putu-studio/AI_Pin/hardware/production/bom.csv

Designator | Footprint | Quantity | Value | LCSC Part #
C1 | 0603 | 1 | 10uF | C19702
C2 | 0603 | 1 | 100nF | C14663
C3, C4, C5, C9 | 0603 | 4 | 100 nF | C14663
C6 | 1206 | 1 | 47 uF | C96123
C7, C8 | 0805 | 2 | 10 uF | C15850
D1 | 0603 | 1 | red LED | C2286
D2 | 0603 | 1 | green LED | C84267
D3 | D_SOD-123F | 1 | SMF5.0A | C284108
J4 | USB_C_Receptacle_HRO_TYPE-C-31-M-12 | 1 | USB_C_Receptacle_USB2.0_16P | C165948
Q1 | SOT-23 | 1 | Q_PMOS_GSD | C15127
R1, R2, R8 | 0603 | 3 | 100 kΩ | C25803
R3 | 0603 | 1 | 2.4 kΩ | C22940
R4 | 0603 | 1 | 2.2 kΩ | C4190
R5 | 0603 | 1 | 4.7 kΩ | C23162
R6, R7 | 0603 | 2 | 5.1 kΩ | C23186
SW1 | SW_Talk_6x6_TS6635PA | 1 | SW_talk | C55213946
SW2 | SW_Side_TS1114S | 1 | SW_pages | C596266
SW3 | SW_Side_TS1114S | 1 | SW_settings | C596266
SW4 | SW_Slide_MSK12C02HB | 1 | SW_SPDT | C431541
U2 | SOIC-8-1EP_3.9x4.9mm_P1.27mm_EP2.41x3.3mm | 1 | TP4056-42-ESOP8 | C16581
