putu-studio/AI_Pin/hardware/aipin-carrier.kicad_pcb

## KiCad design hardware/aipin-carrier.kicad_pcb (2026-11-07)

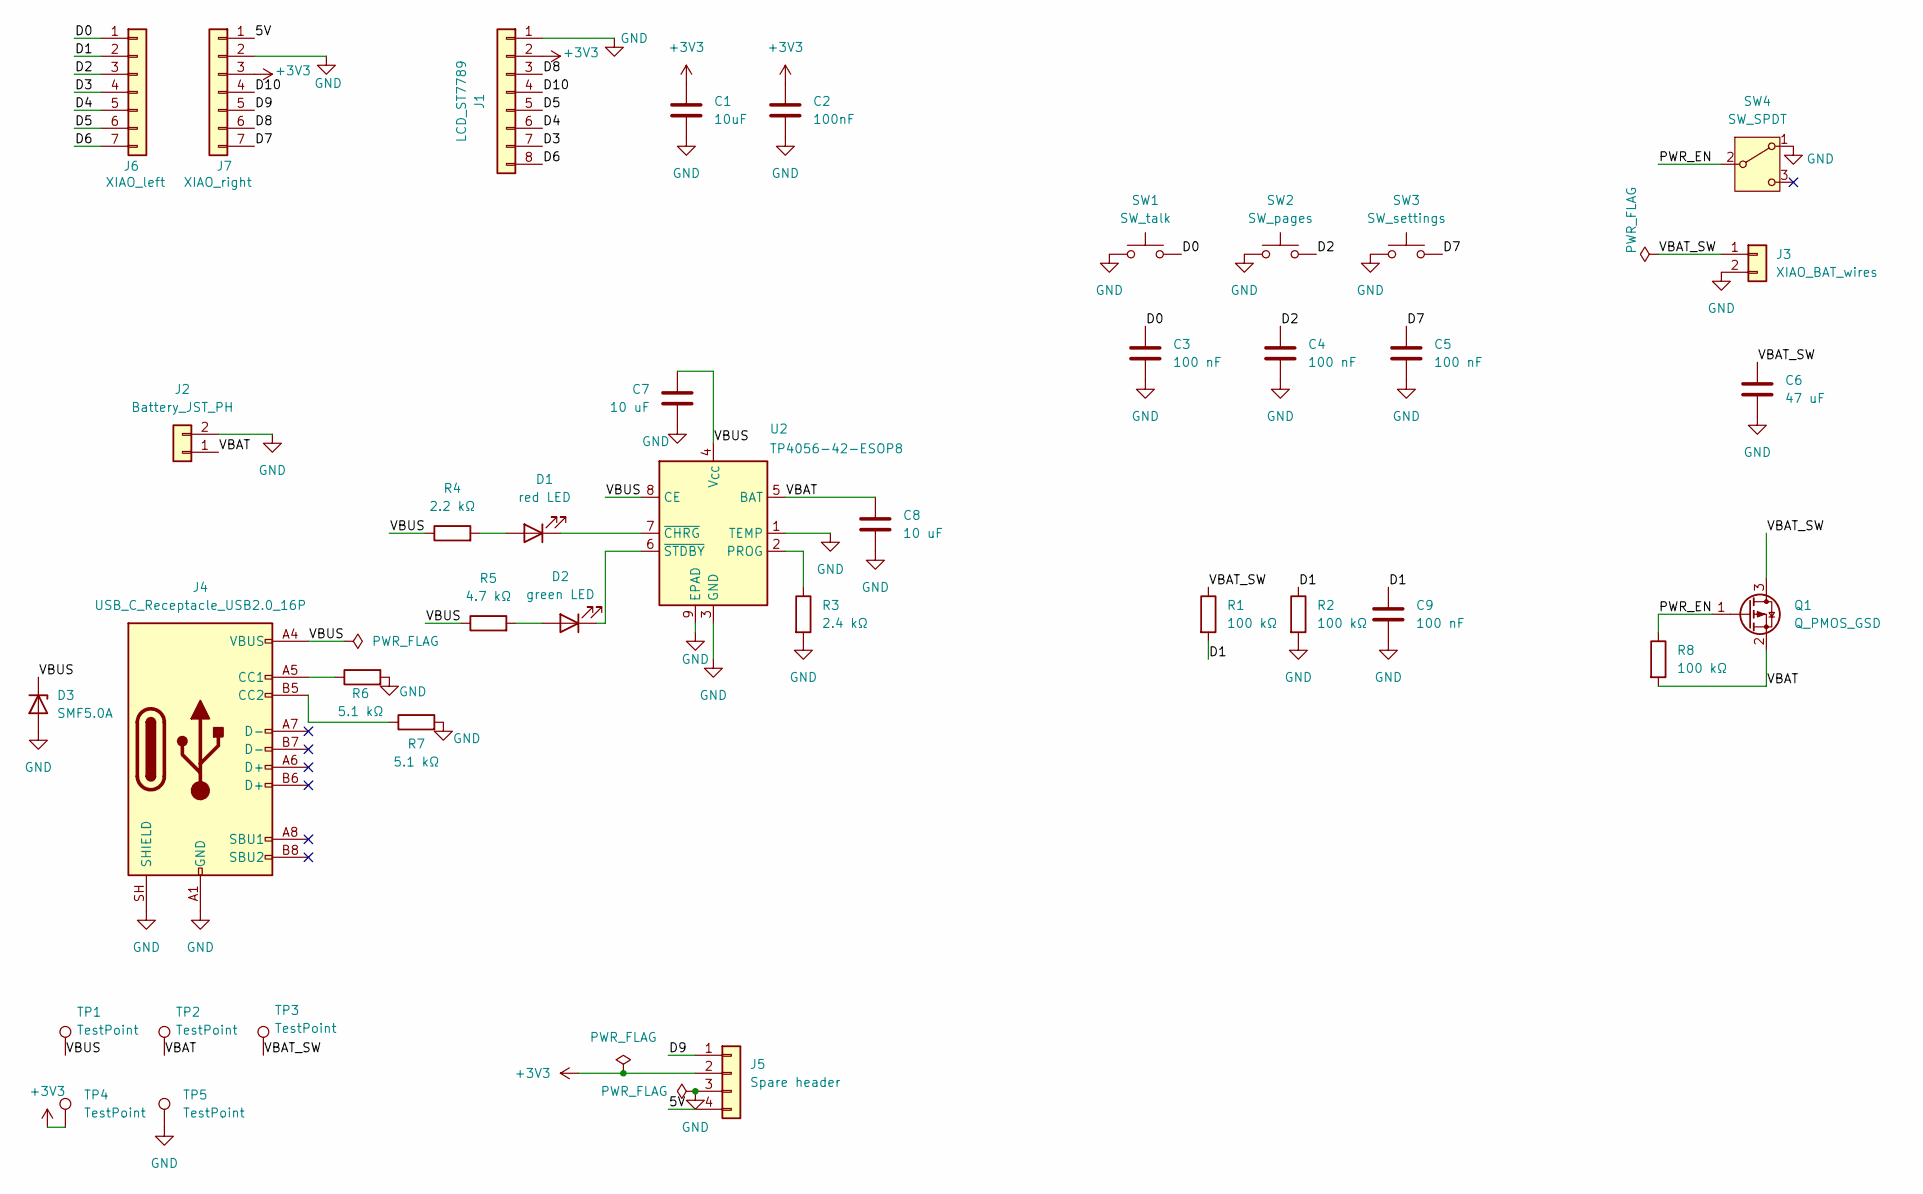
[picture p1: schematic aipin-carrier.kicad_sch]

Parts:
C1: 10uF; C_0603_1608Metric; LCSC C19702
C2: 100nF; C_0603_1608Metric; LCSC C14663
C3, C4, C5, C9: 100 nF; C_0603_1608Metric; LCSC C14663
C6: 47 uF; C_1206_3216Metric; LCSC C96123
C7, C8: 10 uF; C_0805_2012Metric; LCSC C15850
D1: red LED; LED_0603_1608Metric; LCSC C2286
D2: green LED; LED_0603_1608Metric; LCSC C84267
D3: SMF5.0A; D_SOD-123F; LCSC C284108
J1: LCD_ST7789; PinSocket_1x08_P2.54mm_Vertical
J2: Battery_JST_PH; JST_PH_S2B-PH-K_1x02_P2.00mm_Horizontal
J3: XIAO_BAT_wires; PinHeader_1x02_P2.54mm_Vertical
J4: USB_C_Receptacle_USB2.0_16P; USB_C_Receptacle_HRO_TYPE-C-31-M-12; LCSC C165948
J5: Spare header; PinHeader_1x04_P2.54mm_Vertical
J6: XIAO_left; PinSocket_1x07_P2.54mm_Vertical
J7: XIAO_right; PinSocket_1x07_P2.54mm_Vertical
Q1: Q_PMOS_GSD; SOT-23; LCSC C15127
R1, R2, R8: 100 kΩ; R_0603_1608Metric; LCSC C25803
R3: 2.4 kΩ; R_0603_1608Metric; LCSC C22940
R4: 2.2 kΩ; R_0603_1608Metric; LCSC C4190
R5: 4.7 kΩ; R_0603_1608Metric; LCSC C23162
R6, R7: 5.1 kΩ; R_0603_1608Metric; LCSC C23186
SW1: SW_talk; SW_Talk_6x6_TS6635PA; LCSC C55213946
SW2: SW_pages; SW_Side_TS1114S; LCSC C596266
SW3: SW_settings; SW_Side_TS1114S; LCSC C596266
SW4: SW_SPDT; SW_Slide_MSK12C02HB; LCSC C431541
TP1, TP2, TP3, TP4, TP5: TestPoint; TestPoint_Pad_D1.5mm
U2: TP4056-42-ESOP8; SOIC-8-1EP_3.9x4.9mm_P1.27mm_EP2.41x3.3mm; LCSC C16581

Connections:
+3V3: C1.1, C2.1, J1.2, J5.2, J7.3, TP4.1 (1_1)
/5V: J5.4, J7.1
/D0: C3.1, J6.1, SW1.2
/D1: C9.1, J6.2, R1.2, R2.1
/D2: C4.1, J6.3, SW2.2
/D3: J1.7, J6.4
/D4: J1.6, J6.5
/D5: J1.5, J6.6
/D6: J1.8, J6.7
/D7: C5.1, J7.7, SW3.2
/D8: J1.3, J7.6
/D9: J5.1, J7.5
/D10: J1.4, J7.4
/PWR_EN: Q1.1 (G), R8.1, SW4.2 (B)
/VBAT: C8.1, J2.1, Q1.2 (S), R8.2, TP2.1 (1_1), U2.5 (BAT)
/VBAT_SW: C6.1, J3.1, Q1.3 (D), R1.1, TP3.1 (1_1)
/VBUS: C7.1, D3.1 (K), J4.A4 (VBUS), J4.A9 (VBUS), J4.B4 (VBUS), J4.B9 (VBUS), R4.1, R5.1, TP1.1 (1_1), U2.4 (V_{CC}), U2.8 (CE)
GND: C1.2, C2.2, C3.2, C4.2, C5.2, C6.2, C7.2, C8.2, C9.2, D3.2 (A), J1.1, J2.2, J3.2, J4.A1 (GND), J4.A12 (GND), J4.B1 (GND), J4.B12 (GND), J4.SH (SHIELD), J5.3, J7.2, R2.2, R3.2, R6.2, R7.2, SW1.1, SW2.1, SW3.1, SW4.1 (A), TP5.1 (1_1), U2.1 (TEMP), U2.3 (GND), U2.9 (EPAD)
unnamed: D1.2 (A), R4.2
unnamed: D1.1 (K), U2.7 (~CHRG)
unnamed: D2.2 (A), R5.2
unnamed: D2.1 (K), U2.6 (~STDBY)
unnamed: J4.A5 (CC1), R6.1
unnamed: J4.B5 (CC2), R7.1
unnamed: R3.1, U2.2 (PROG)

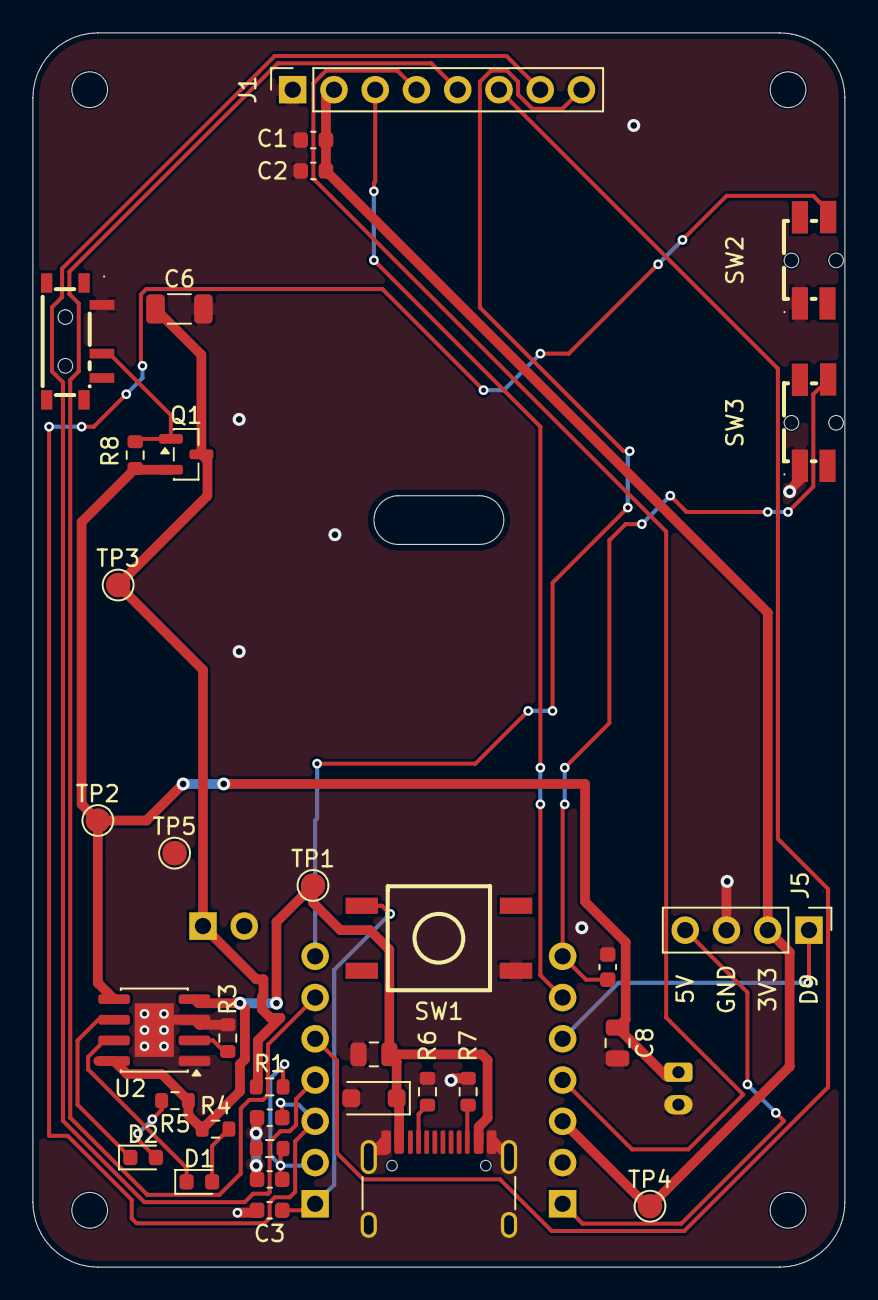
[picture p2: board aipin-carrier.kicad_pcb from above]

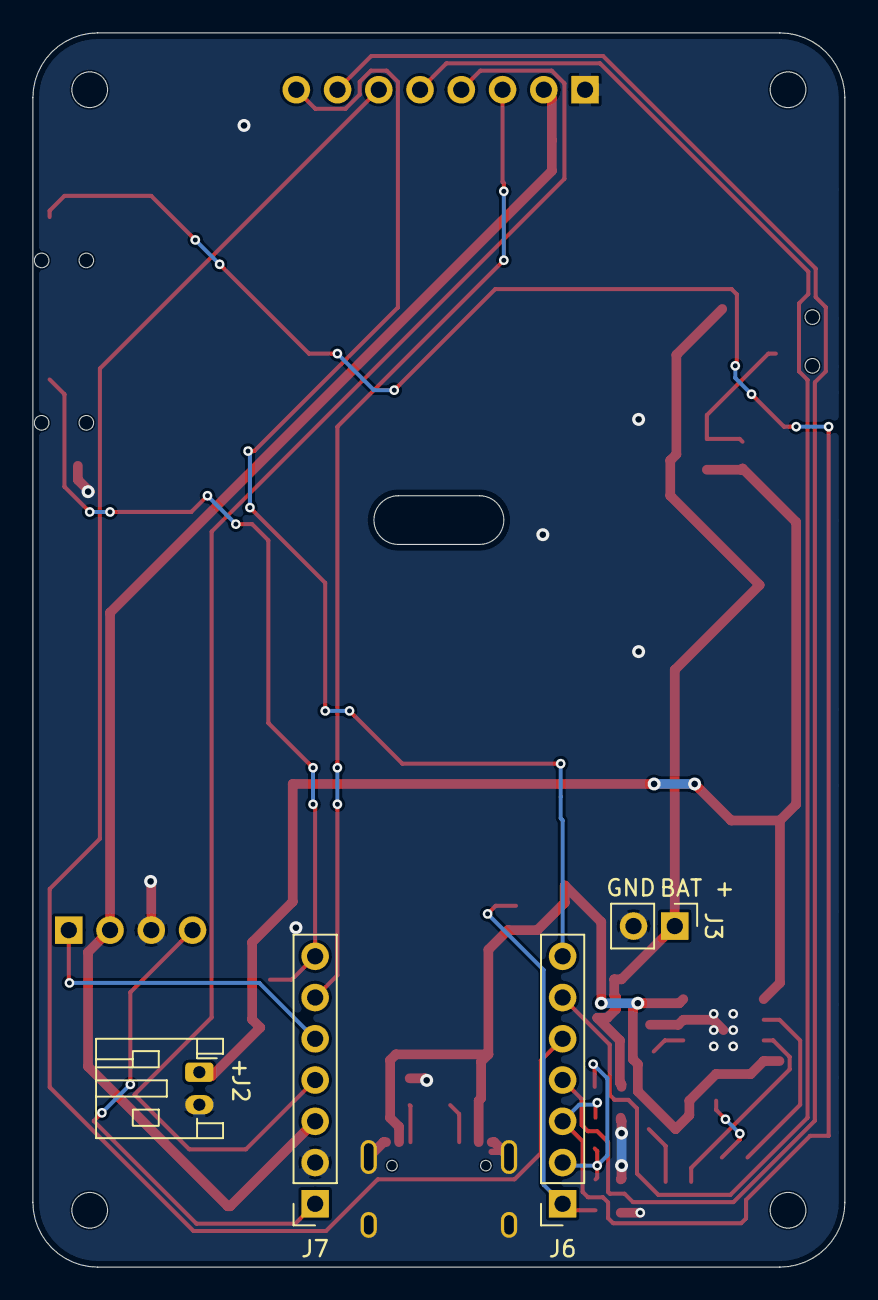
[picture p3: board aipin-carrier.kicad_pcb from below]

Board: 2 copper layers, 50.0 x 76.0 mm, 42 parts (4 on the bottom side), 25 nets.

Other parts of the board:
H1, H2, H3, H4: MountingHole_2.2mm_M2
